AdibFridiansya/WCT-526AT/ATM90E26_Arduino/docs/examples/energyic_SPI.h

/* ATM90E26 Energy Monitor Demo Application

    The MIT License (MIT)

  Copyright (c) 2016 whatnick and Ryzee

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
  THE SOFTWARE IS PROVIDED "AS IS", WITHOUT WARRANTY OF ANY KIND, EXPRESS OR
  IMPLIED, INCLUDING BUT NOT LIMITED TO THE WARRANTIES OF MERCHANTABILITY,
  FITNESS FOR A PARTICULAR PURPOSE AND NONINFRINGEMENT. IN NO EVENT SHALL THE
  AUTHORS OR COPYRIGHT HOLDERS BE LIABLE FOR ANY CLAIM, DAMAGES OR OTHER
  LIABILITY, WHETHER IN AN ACTION OF CONTRACT, TORT OR OTHERWISE, ARISING FROM,
  OUT OF OR IN CONNECTION WITH THE SOFTWARE OR THE USE OR OTHER DEALINGS IN THE
  SOFTWARE.
*/

#ifndef __ATM90E26_SPI_H__
#define __ATM90E26_SPI_H__

#include <Arduino.h>

#define SoftReset 0x00 // Software Reset
#define SysStatus 0x01 // System Status
#define FuncEn 0x02    // Function Enable
#define SagTh 0x03     // Voltage Sag Threshold
#define SmallPMod 0x04 // Small-Power Mode
#define LastData 0x06  // Last Read/Write SPI/UART Value
#define LSB 0x08       // RMS/Power 16-bit LSB
#define CalStart 0x20  // Calibration Start Command
#define PLconstH 0x21  // High Word of PL_Constant
#define PLconstH_Default 0x0015
#define PLconstL 0x22 // Low Word of PL_Constant
#define PLconstL_Default 0xD174
#define Lgain 0x23 // L Line Calibration Gain
#define Lgain_Default 0x0000
#define Lphi 0x24 // L Line Calibration Angle
#define Lphi_Default 0x0000
#define Ngain 0x25 // N Line Calibration Gain
#define Ngain_Default 0x0000
#define Nphi 0x26 // N Line Calibration Angle
#define Nphi_Default 0x0000
#define PStartTh 0x27 // Active Startup Power Threshold
#define PStartTh_Default 0x08BD
#define PNolTh 0x28 // Active No-Load Power Threshold
#define PNolTh_Default 0x0000
#define QStartTh 0x29 // Reactive Startup Power Threshold
#define QStartTh_Default 0x0AEC
#define QNolTh 0x2A // Reactive No-Load Power Threshold
#define QNolTh_Default 0x0000
#define MMode 0x2B // Metering Mode Configuration
#define MMode_Default 0x9422
#define CSOne 0x2C    // Checksum 1
#define AdjStart 0x30 // Measurement Calibration Start Command
#define Ugain 0x31    // Voltage rms Gain
#define Ugain_Default 0x6720
#define IgainL 0x32 // L Line Current rms Gain
#define IgainL_Default 0x7A13
#define IgainN 0x33 // N Line Current rms Gain
#define IgainN_Default 0x7530
#define Uoffset 0x34 // Voltage Offset
#define Uoffset_Default 0x0000
#define IoffsetL 0x35 // L Line Current Offset
#define IoffsetL_Default 0x0000
#define IoffsetN 0x36 // N Line Current Offse
#define IoffsetN_Default 0x0000
#define PoffsetL 0x37 // L Line Active Power Offset
#define PoffsetL_Default 0x0000
#define QoffsetL 0x38 // L Line Reactive Power Offset
#define QoffsetL_Default 0x0000
#define PoffsetN 0x39 // N Line Active Power Offset
#define PoffsetN_Default 0x0000
#define QoffsetN 0x3A // N Line Reactive Power Offset
#define QoffsetN_Default 0x0000
#define CSTwo 0x3B     // Checksum 2
#define APenergy 0x40  // Forward Active Energy
#define ANenergy 0x41  // Reverse Active Energy
#define ATenergy 0x42  // Absolute Active Energy
#define RPenergy 0x43  // Forward (Inductive) Reactive Energy
#define Rnenerg 0x44   // Reverse (Capacitive) Reactive Energy
#define Rtenergy 0x45  // Absolute Reactive Energy
#define EnStatus 0x46  // Metering Status
#define Irms 0x48      // L Line Current rms
#define Urms 0x49      // Voltage rms
#define Pmean 0x4A     // L Line Mean Active Power
#define Qmean 0x4B     // L Line Mean Reactive Power
#define Freq 0x4C      // Voltage Frequency
#define PowerF 0x4D    // L Line Power Factor
#define Pangle 0x4E    // Phase Angle between Voltage and L Line Current
#define Smean 0x4F     // L Line Mean Apparent Power
#define IrmsTwo 0x68   // N Line Current rms
#define PmeanTwo 0x6A  // N Line Mean Active Power
#define QmeanTwo 0x6B  // N Line Mean Reactive Power
#define PowerFTwo 0x6D // N Line Power Factor
#define PangleTwo 0x6E // Phase Angle between Voltage and N Line Current
#define SmeanTwo 0x6F  // N Line Mean Apparent Power

// pins used for the connection with the sensor
// the other you need are controlled by the SPI library):
// const int energy_IRQ = 2;
#if defined(ARDUINO_ESP8266_WEMOS_D1MINI) // WeMos mini and D1 R2
const int energy_CS = D8;                 // WEMOS SS pin
#elif defined(ARDUINO_ESP8266_ESP12)      // Adafruit Huzzah
const int energy_CS = 15; // HUZZAH SS pins ( 0 or 15)
#elif defined(ARDUINO_ARCH_SAMD)          // M0 board
const int energy_CS = 10; // M0 SS pin
#elif defined(__AVR_ATmega32U4__)         // 32u4 board
const int energy_CS = 10; // 32u4 SS pin
#else
const int energy_CS = SS; // Use default SS pin for unknown Arduino
#endif // defined(ARDUINO_ESP8266_WEMOS_D1MINI)

class ATM90E26_SPI {
public:
  ATM90E26_SPI(int pin = energy_CS);
  double GetLineVoltage();
  double GetLineCurrent();
  double GetActivePower();
  double GetReactivePower();
  double GetApparentPower();
  double GetPhaseAngle();
  double GetFrequency();
  double GetPowerFactor();
  double GetImportEnergy();
  double GetExportEnergy();
  void SetUGain(unsigned short);
  void SetLGain(unsigned short);
  void SetIGain(unsigned short);
  void InitEnergyIC();
  void CalibrateEnergyIC();
  unsigned short GetSysStatus();
  unsigned short GetMeterStatus();

private:
public:
  unsigned short CommEnergyIC(unsigned char RW, unsigned char address,
                              unsigned short val);
  unsigned short CalcCheckSum(int checksum_id);
  int _cs;

  unsigned short metering[11];
  enum metering_values {
    _plconsth,
    _plconstl,
    _lgain,
    _lphi,
    _ngain,
    _nphi,
    _pstartth,
    _pnolth,
    _qstartth,
    _qnolth,
    _mmode
  };
  unsigned short _crc1;
  unsigned short measurement[10];
  enum measurement_values {
    _ugain,
    _igain,
    _igainn,
    _uoffset,
    _ioffestl,
    _ioffsetn,
    _poffestl,
    _qoffsetl,
    _poffsetn,
    _qoffsetn
  };
  unsigned short _crc2;
};

#endif
